Kurt-E-Clothier/javamon/README.md

##Javamon - IoT Coffee Pot Monitor

####master
* **atmega328p** - source code for the mega328p main controller
* **esp8266** - source code for the ESP8266 WiFi module
* **schematics** - Cadsoft Eagle schematic file for the project

####gh-pages
* **index.html** - web interface for the coffee pot monitor
* **styles.css** - styling for the web interface
