Kurt-E-Clothier/javamon/schematics/javamon-v3.0.png

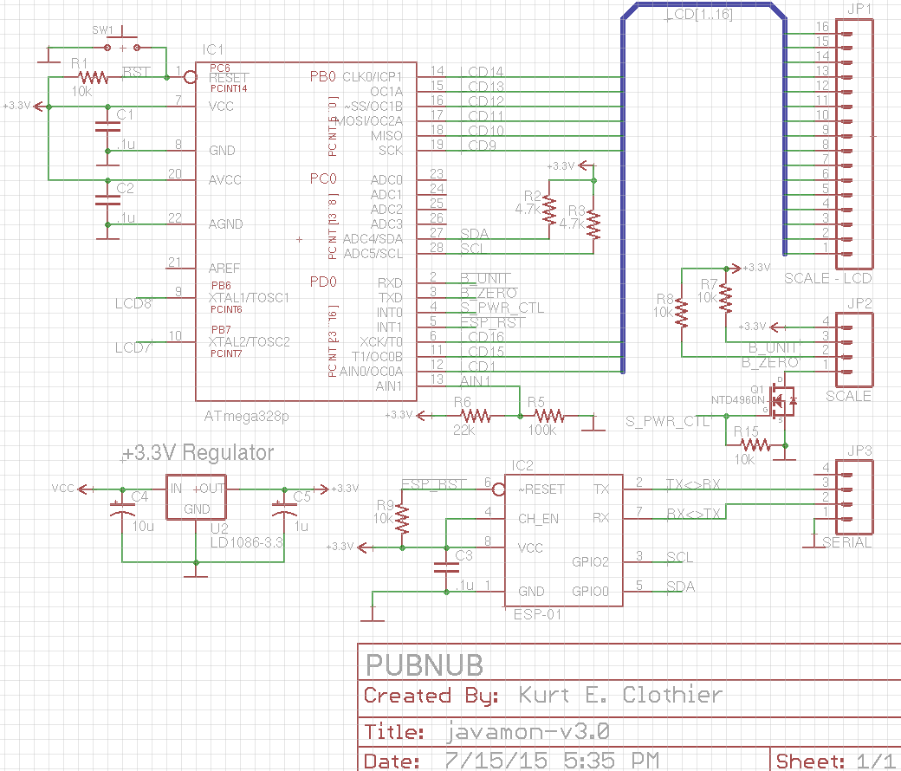
schematics/javamon-v3.0.png
