Kurt-E-Clothier/javamon/schematics/javamon-v3.0.sch

## EAGLE design schematics/javamon-v3.0.sch (2015-07-16)

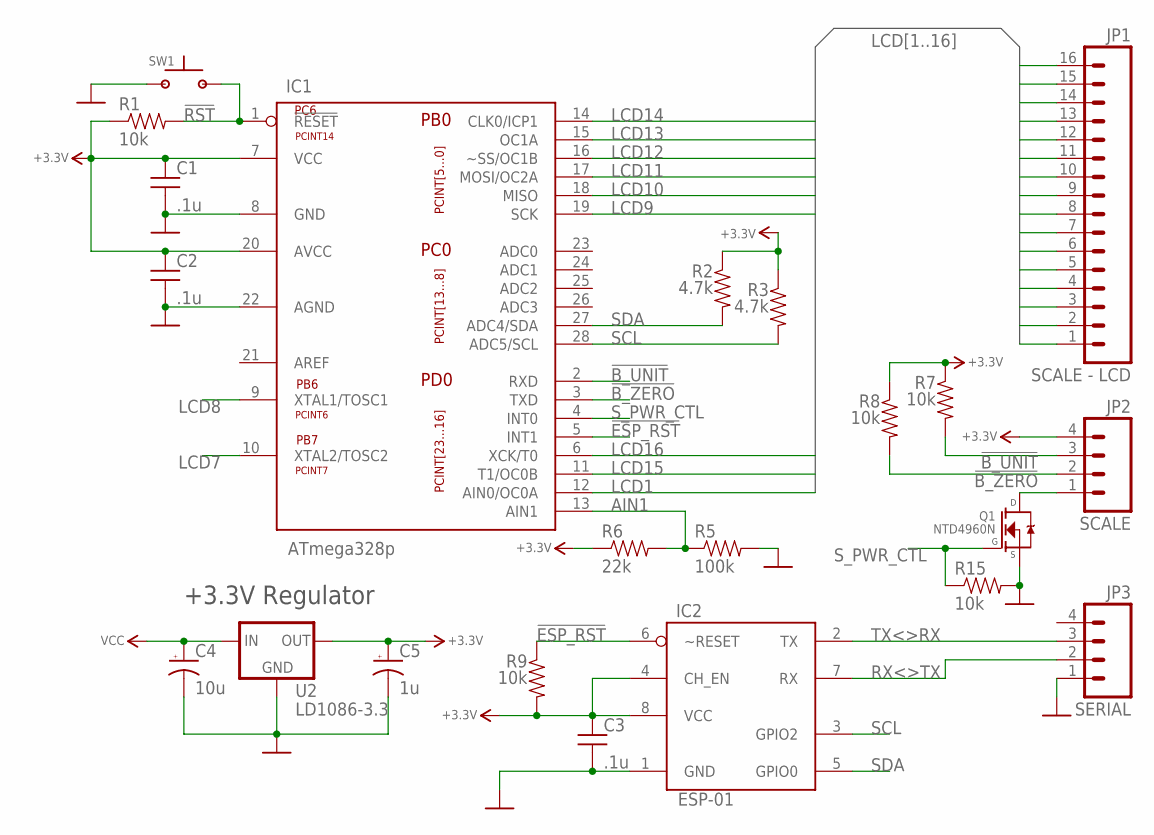
[picture p2: schematic javamon-v3.0.sch]

Parts:
C1, C2: .1u; 0805
C3: .1u; 1206
C4: 10u; CPOL_RADIAL-1020
C5: 1u; CPOL_RADIAL-1020
IC1: ATmega328p; 28P3-SOCKET
IC2: ESP-01; 2X04
JP1: SCALE - LCD; 1X16_LOCK_LONGPADS
JP2: SCALE; 1X04_LOCK_LONGPADS
JP3: SERIAL; 1X04_LOCK_LONGPADS
Q1: NTD4960N; TO-251_(IPAK)
R1, R7, R8, R15: 10k; 0805
R2, R3: 4.7k; 0805
R5: 100k; 0805
R6: 22k; 0805
R9: 10k; 1206
SW1: SPST_OFF-MOM-TACTILE-PTH; TACTILE-PTH
U2: LD1086-3.3; TO-92

Connections:
!B_UNIT: IC1.2 (RXD), JP2.3, R7.2
!B_ZERO: IC1.3 (TXD), JP2.2, R8.2
!ESP_RST: IC1.5 (INT1), IC2.6 (~RESET), R9.1
!RST: IC1.1 (!RESET), R1.2, SW1.3 (2)
+3.3V: C1.1, C2.1, C3.1, C5.1, IC1.7 (VCC), IC1.20 (AVCC), IC2.4 (CH_EN), IC2.8 (VCC), JP2.4, R1.1, R2.1, R3.1, R6.1, R7.1, R8.1, R9.2, U2.3 (OUT)
AIN1: IC1.13 (AIN1), R5.1, R6.2
GND-D: C1.2, C2.2, C3.2, C4.2, C5.2, IC1.8 (GND), IC1.22 (AGND), IC2.1 (GND), JP3.1, Q1.3 (S), R5.2, R15.2, SW1.1, U2.1 (GND)
LCD1: IC1.12 (AIN0/OC0A), JP1.1
LCD2: JP1.2
LCD3: JP1.3
LCD4: JP1.4
LCD5: JP1.5
LCD6: JP1.6
LCD7: IC1.10 (XTAL2/TOSC2), JP1.7
LCD8: IC1.9 (XTAL1/TOSC1), JP1.8
LCD9: IC1.19 (SCK), JP1.9
LCD10: IC1.18 (MISO), JP1.10
LCD11: IC1.17 (MOSI/OC2A), JP1.11
LCD12: IC1.16 (~SS/OC1B), JP1.12
LCD13: IC1.15 (OC1A), JP1.13
LCD14: IC1.14 (CLK0/ICP1), JP1.14
LCD15: IC1.11 (T1/OC0B), JP1.15
LCD16: IC1.6 (XCK/T0), JP1.16
unnamed: JP2.1, Q1.2 (D)
RX<>TX: IC2.7 (RX), JP3.2
SCL: IC1.28 (ADC5/SCL), IC2.3 (GPIO2), R3.2
SDA: IC1.27 (ADC4/SDA), IC2.5 (GPIO0), R2.2
S_PWR_CTL: IC1.4 (INT0), Q1.1 (G), R15.1
TX<>RX: IC2.2 (TX)
VCC: C4.1, U2.2 (IN)

Notes on the sheet:
+3.3V Regulator
