Kurt-E-Clothier/javamon/(commit log)

2015-07-15 new schematics
    [javamon-v2.0.sch]
2015-07-16 circuit redesign
    [javamon-v3.0.sch]
